iot4agri/smart-biodigester/system-architecture.png

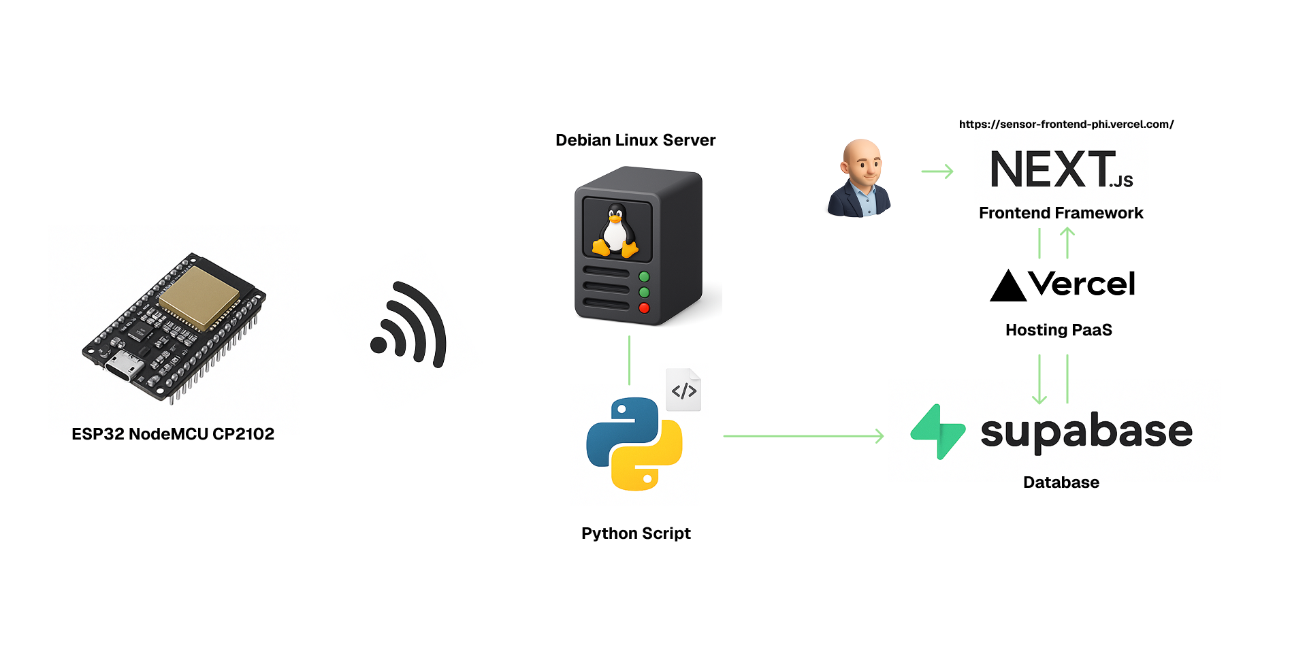
system-architecture.png
