iot4agri/smart-biodigester/materials.md

# Materials List

| Quantity | Item | Description | Purchase Location | Price |
|---|---|---|---|---|
| 4 | Stainless steel hose clamp 12-20mm | Clamps for securing gas hose to valves | Hardware Store | 7,96€ |
| 4 | Device connection piece | Connection piece for gas hose to connect to valves | Hardware Store | 11,56€ |
| 1 | Neo Fermit 150g Tube | 90 degree overflow pipe | Hardware Store | 4,79€ |
| 2 | Ball valve pressed brass ½ inch | Gas valves with handle | Hardware Store | 12,38€ |
| 1 | Y-distributor piece | Distributor piece for gas hose | Hardware Store | 8,99€ |
| 1 | Sealing hemp | For sealing the valves | Hardware Store | 2,29€ |
| 1 | Bombenfest PU-adhesive 450g | Assembly adhesive for sealing | Hardware Store | 16,95€ |
| 1 | 3.8m hose clear 16x2mm | Gas hose | Hardware Store | 8,32€ |
| 1 | Mash tun 60L | Fermentation tank | Hardware Store | 37,99€ |
| 1 | Downpipe | Filling pipe | Hardware Store | 8,99€ |
| 1 | Motorcycle inner tube | Gas storage | - | - |
| 1 | pH calibration kit | Calibration of the pH sensor | Amazon.de | 19,95€ |
| 1 | Silica Gel 400g | Gas dehumidification | Amazon.de | 5,99€ |
| 1 | 10 Meter Lapp LiYY data cable 6x0.34 mm2 | Cable for sensors | Amazon.de | 13,86€ |
| 1 | ELEGOO Jumper Wire 40x20cm | Wiring | Amazon.de | 5,94€ |
| 1 | Epoxy resin set 474ml | For sealing | Amazon.de | 12,78€ |
| 1 | UMETASS plastic bottle with wide opening 2 pieces, 500ml | Airtight bottles for silica gel and sensors | Amazon.de | 10,99€ |
| 1 | Rakiuty 2 pieces 2m long USB pigtail | Cable for ESP32 connection | Amazon.de | 6,59€ |
| 1 | BME680 Environmental Sensor | External BME sensor | Amazon.de | 18,15€ |
| 1 | Kaiserberg 10K Ohm resistors (10 pieces) | Resistors for sensor wiring | Amazon.de | 6,50€ |
| 1 | Lumonic 2x0.34mm2 LED control cable black 20m | Wiring | Amazon.de | 34,92€ |
| 1 | 480 pieces cable connectors | Connection set for wiring | Amazon.de | 10,99€ |
| 1 | 2x1M cable with DS18B20 digital stainless steel temperature sensor | Temperature sensors | Amazon.de | 9,99€ |
| 1 | INIR2-ME100-PC Amphenol SGX Sensortech Digital Infrared Gas | Methane gas sensor | Mouser.de | 231,88€ |
| 1 | DFRobot Gravity – pH analog sensor/meter Pro V2 | pH sensor | Botland.de | 71,90€ |
| 1 | ESP32 NodeMCU Module WLAN WiFi Dev Kit C Development Board with CP2102 | ESP32 microcontroller | Amazon.de | 10,99€ |
| 1 | 3D-printed connector between hose and motorcycle inner tube | Connector piece | - | - |
