iot4agri/smart-biodigester/pin-wiring.png

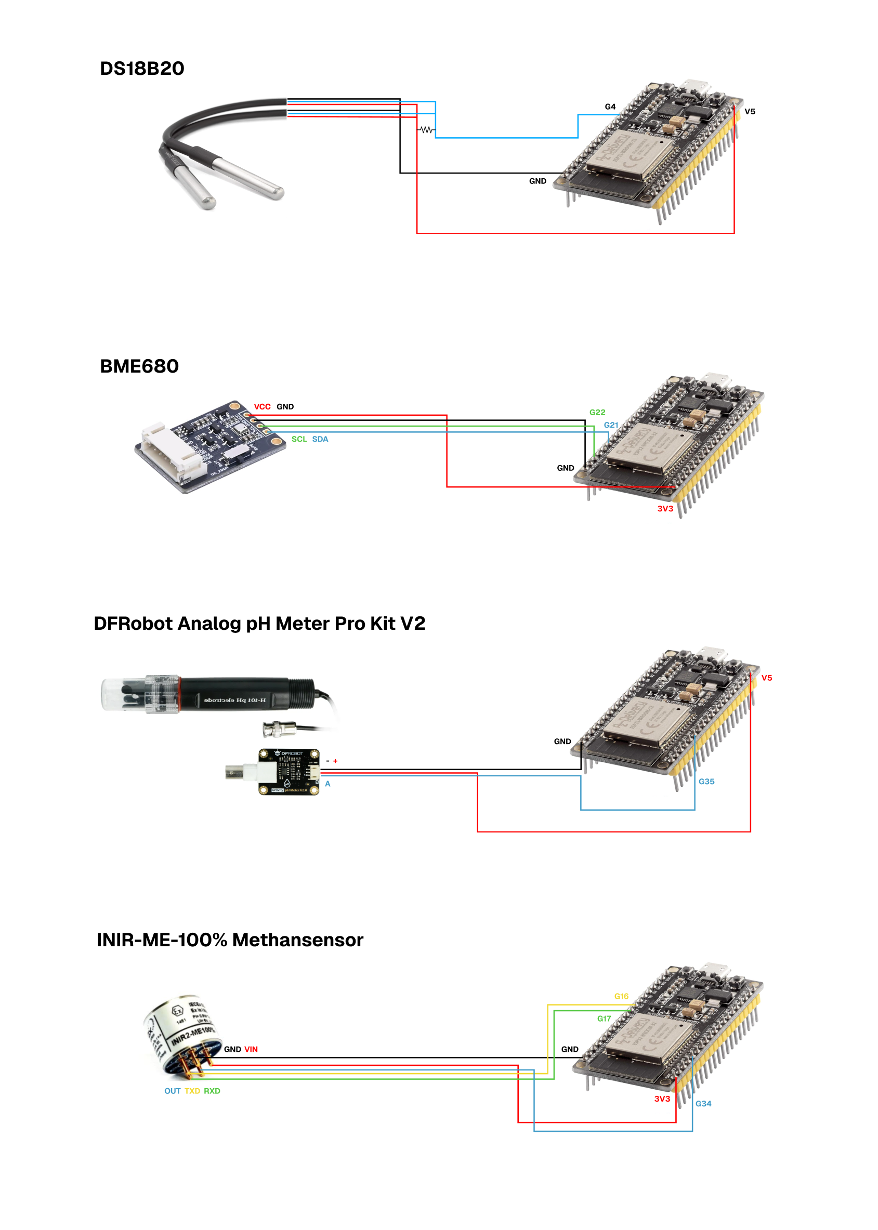
pin-wiring.png
